burgrp/ringle/controller/fp-lib/USB_B_OST_USB-B1HSxx_Horizontal.stp

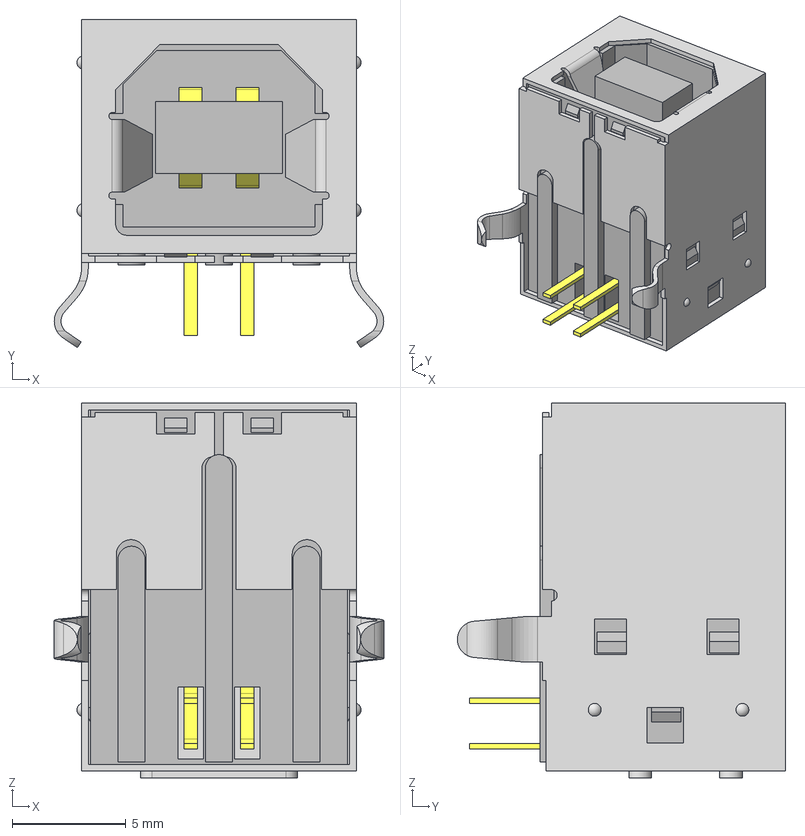
[picture p1: CAD file, 2019-04-11]
controller/fp-lib/USB_B_OST_USB-B1HSxx_Horizontal.stp
14.5 x 14.4 x 16.5 mm
_USB-B-S-TH_S
_USB-B-S-B-TH_B
_USB-B-S-TH_P
