burgrp/ringle/ring/ring.step

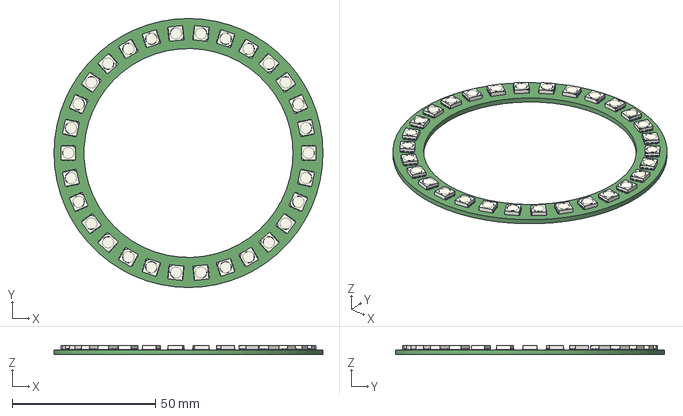
[picture p2: CAD file, 2019-04-11]
ring/ring.step
94.0 x 94.0 x 3.16 mm
