burgrp/ringle/controller/controller.kicad_pcb

## KiCad design controller/controller.kicad_pcb (2019-04-11)

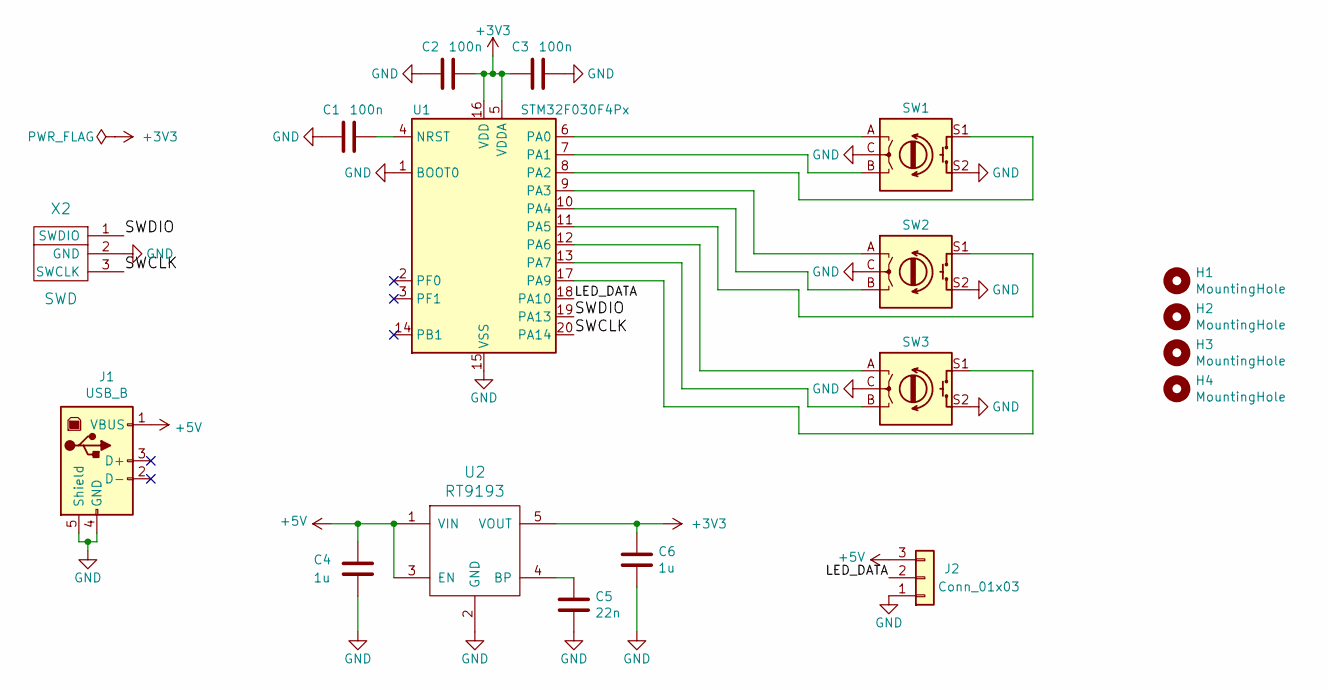
[picture p3: schematic controller.sch]

Parts:
C1, C2, C3: 100n; C_0805_2012Metric_Pad1.15x1.40mm_HandSolder
C4, C6: 1u; C_0805_2012Metric_Pad1.15x1.40mm_HandSolder
C5: 22n; C_0805_2012Metric_Pad1.15x1.40mm_HandSolder
H1, H2, H3, H4: MountingHole; MountingHole_3.7mm_Pad
J1: USB_B; USB_B_OST_USB-B1HSxx_Horizontal
J2: Conn_01x03; JST_XH_S3B-XH-A_1x03_P2.50mm_Horizontal
SW1, SW2, SW3: Rotary_Encoder_Switch; RotaryEncoder_Alps_EC12E-Switch_Vertical_H20mm
U1: STM32F030F4Px; SSOP-20_4.4x6.5mm_P0.65mm
U2: RT9193; SOT-23-5_HandSoldering
X2: SWD

Connections:
+3V3: C2.1, C3.2, C6.1, U1.5 (VDDA), U1.16 (VDD), U2.5 (VOUT)
+5V: C4.1, J1.1 (VBUS), J2.3, U2.1 (VIN), U2.3 (EN)
/LED_DATA: J2.2, U1.18 (PA10)
/SWCLK: U1.20 (PA14), X2.3 (SWCLK)
/SWDIO: U1.19 (PA13), X2.1 (SWDIO)
GND: C1.2, C2.2, C3.1, C4.2, C5.2, C6.2, J1.4 (GND), J1.5 (Shield), J2.1, SW1.C, SW1.S2, SW2.C, SW2.S2, SW3.C, SW3.S2, U1.1 (BOOT0), U1.15 (VSS), U2.2 (GND), X2.2 (GND)
unnamed: C1.1, U1.4 (NRST)
unnamed: C5.1, U2.4 (BP)
unnamed: SW1.A, U1.6 (PA0)
unnamed: SW1.B, U1.7 (PA1)
unnamed: SW1.S1, U1.8 (PA2)
unnamed: SW2.A, U1.9 (PA3)
unnamed: SW2.B, U1.10 (PA4)
unnamed: SW2.S1, U1.11 (PA5)
unnamed: SW3.A, U1.12 (PA6)
unnamed: SW3.B, U1.13 (PA7)
unnamed: SW3.S1, U1.17 (PA9)

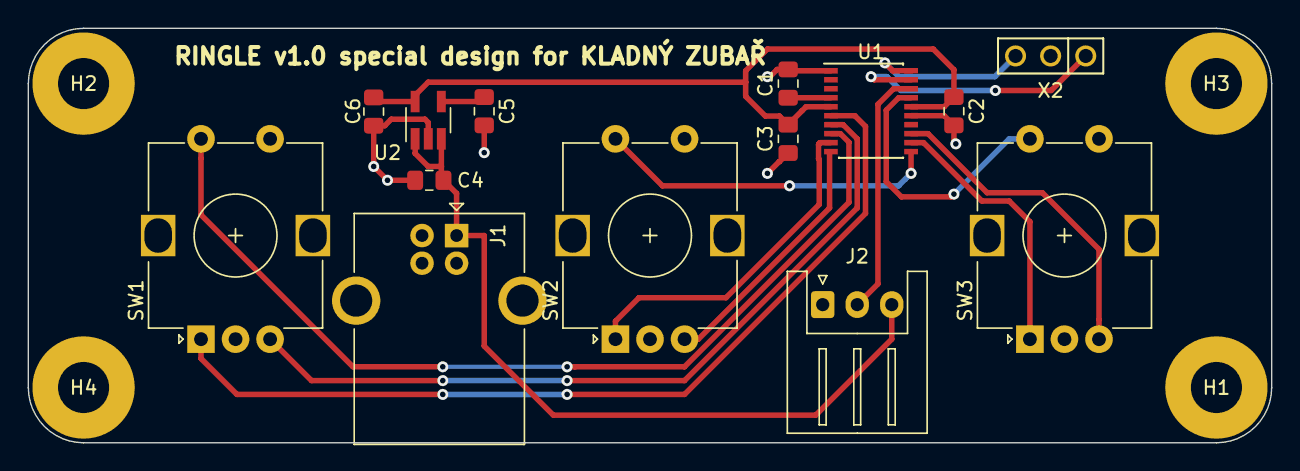
[picture p4: board controller.kicad_pcb from above]

Board: 2 copper layers, 90.0 x 30.0 mm, 18 parts (0 on the bottom side), 17 nets.
